STForyoung/SoccerLauncher/files/designSkribble.jpg

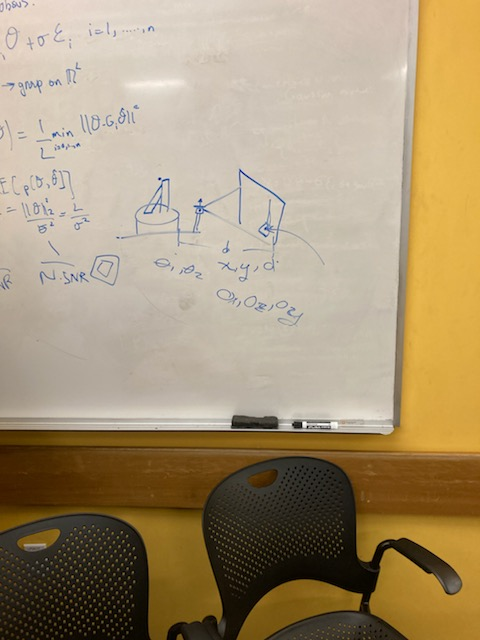
files/designSkribble.jpg
