STForyoung/SoccerLauncher/images/IMG-8528.jpg

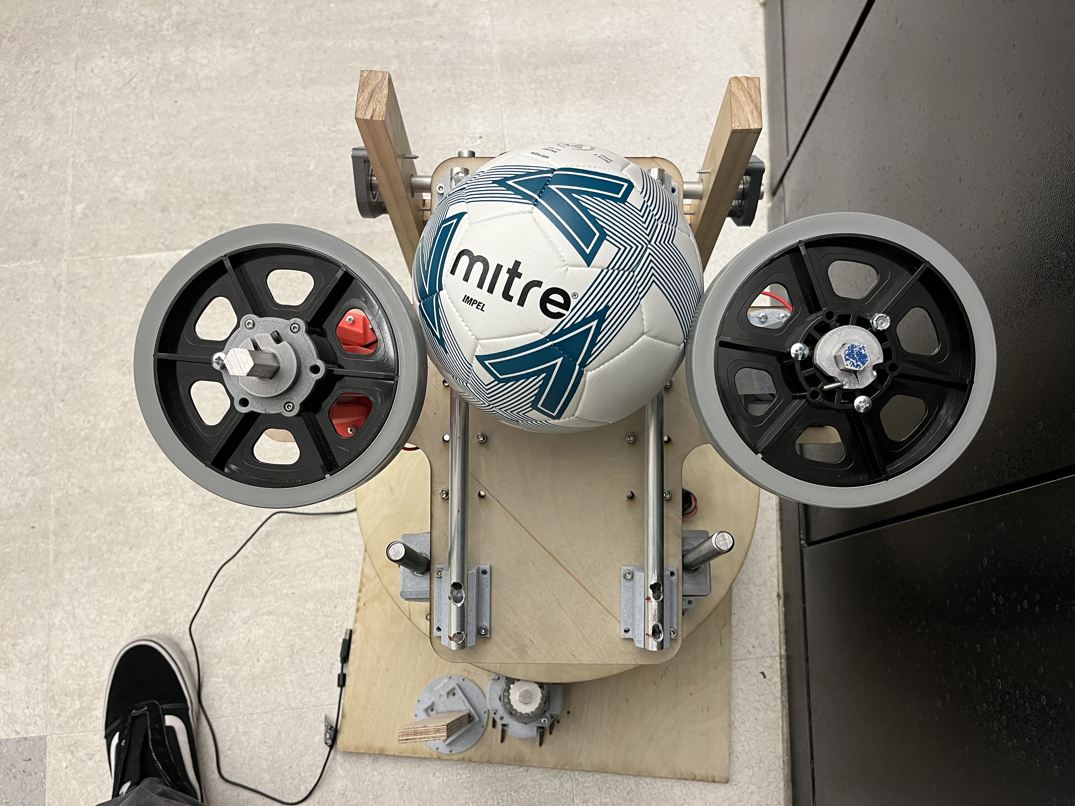
images/IMG-8528.jpg
