STForyoung/SoccerLauncher/images/IMG-8530.jpg

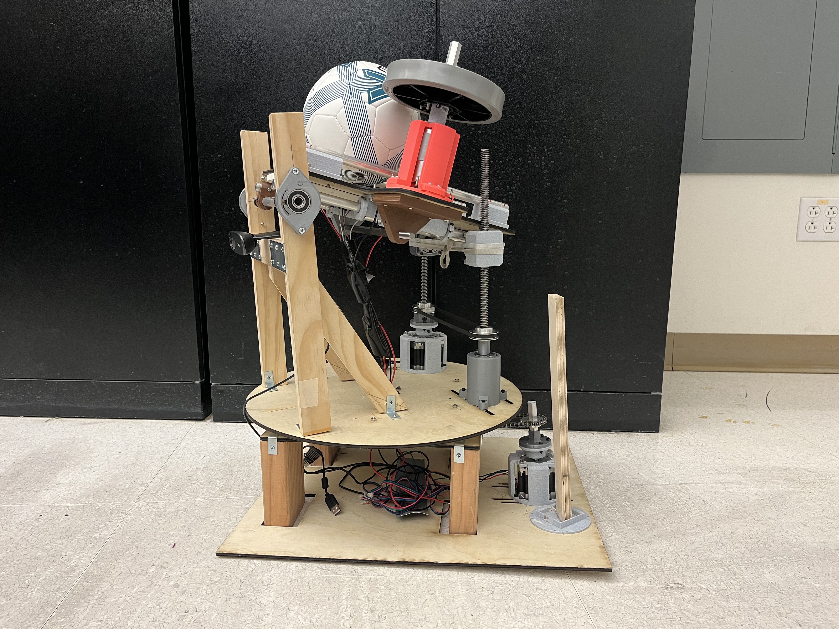
images/IMG-8530.jpg
