STForyoung/SoccerLauncher/images/kaushal.jpg

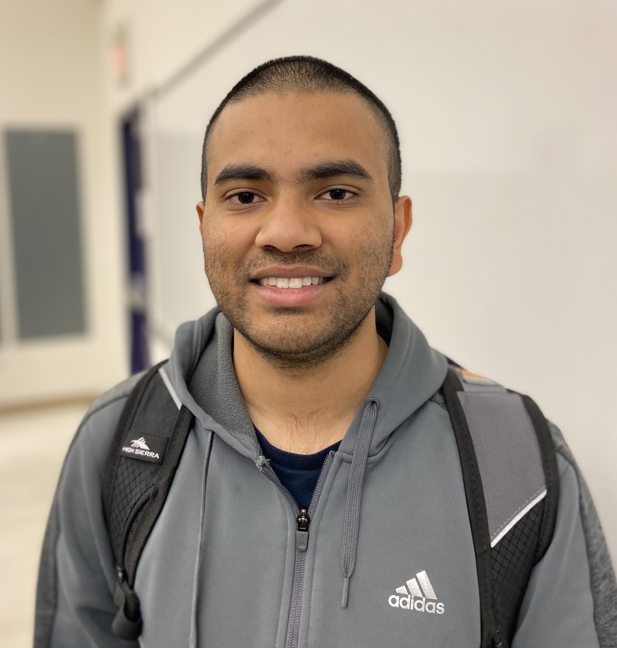
images/kaushal.jpg
