STForyoung/SoccerLauncher/images/neil.jpg

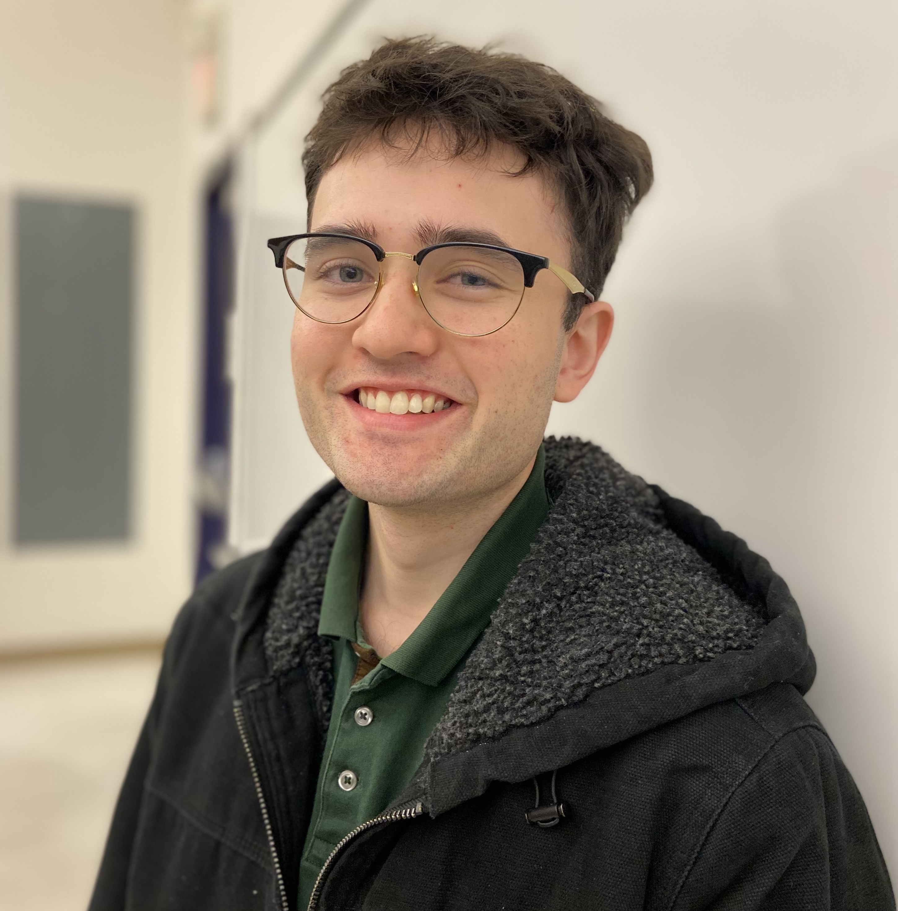
images/neil.jpg
