STForyoung/SoccerLauncher/images/sebastian.jpg

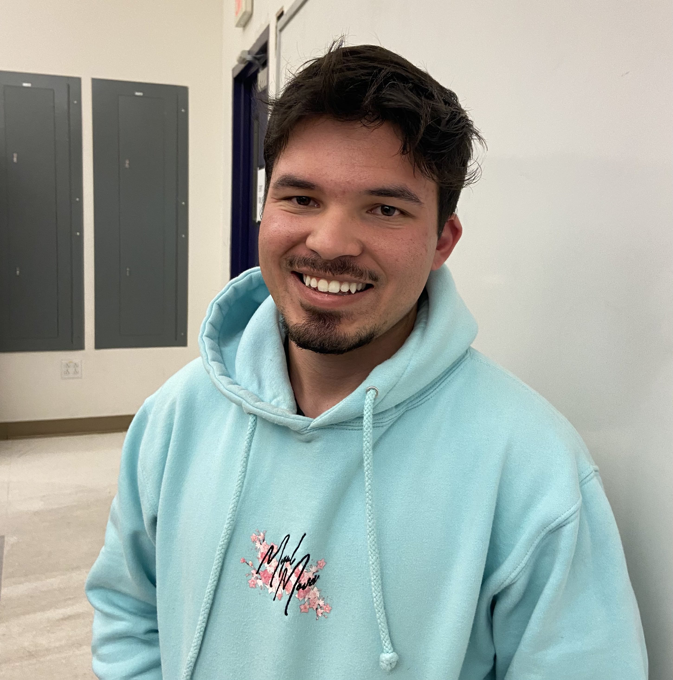
images/sebastian.jpg
