STForyoung/SoccerLauncher/images/steve.jpg

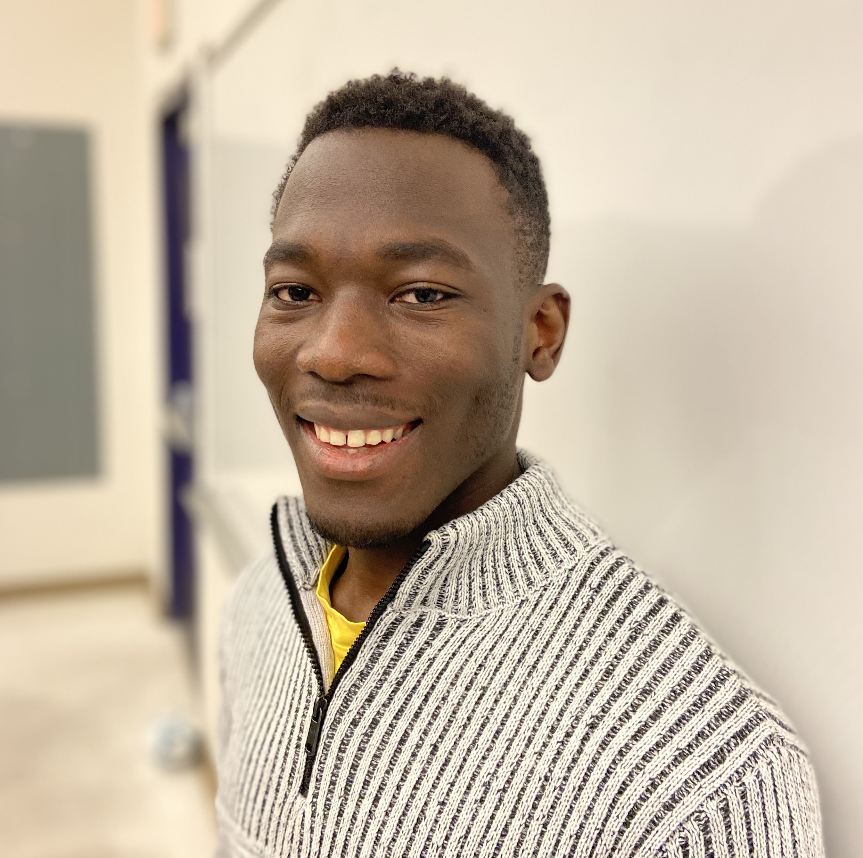
images/steve.jpg
