STForyoung/SoccerLauncher/results.html

### Results

###### Building your own robot is rewarding, but very difficult.

###### Most of our time was spent designing, fabricating, and assembling our robot. We consider its mechanical design to be mostly a success. The basic design is that launch pitch is adjusted by moving one of the attachment points up and down a leadscrew while the yaw is adjusted with chain and sprocket.

iphone-mockup

###### Some of the cool mechical/design features include the turnbuckle that allows us to change the distance between the shooter wheels and adjust compression of the soccer ball.

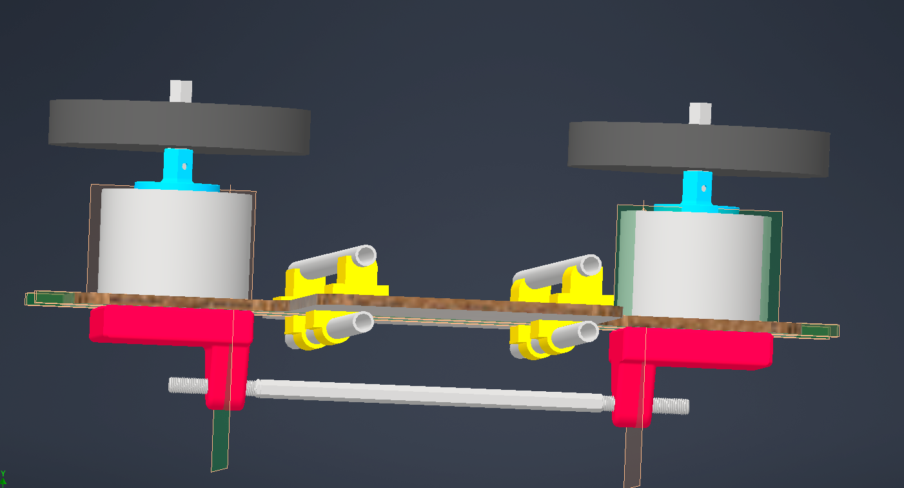
[picture p12: images/turn_buckle.png]


###### There were also 3D printed parts that needed to attach to threaded components. Due to the unreliability of a plastic thread, we decided to insert nuts into the parts during printing.

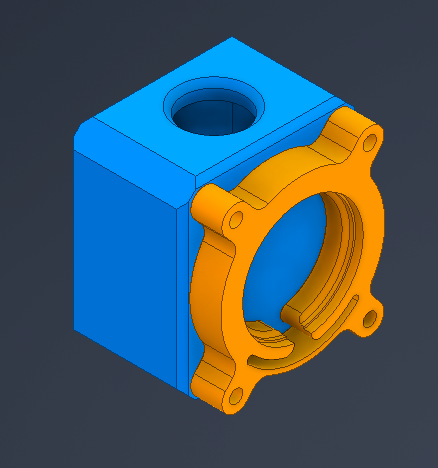
[picture p13: images/bearing_on_screw.PNG]
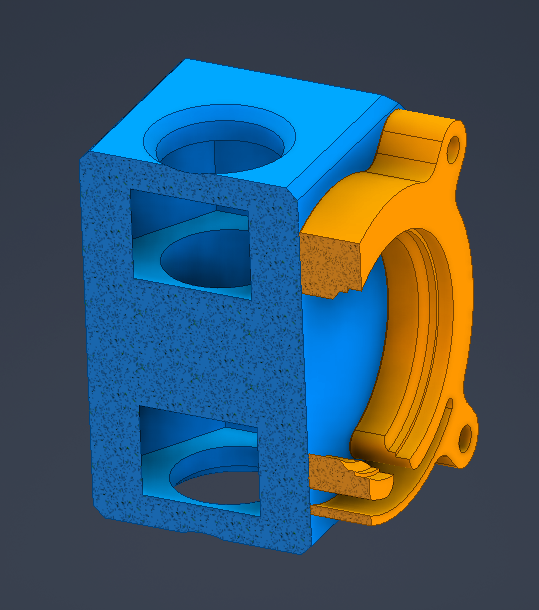
[picture p14: images/half_section.PNG]
 

###### The pulley and chain need the right amount of tension, so we design slots into our laser cut pieces in order to make these adjustable.

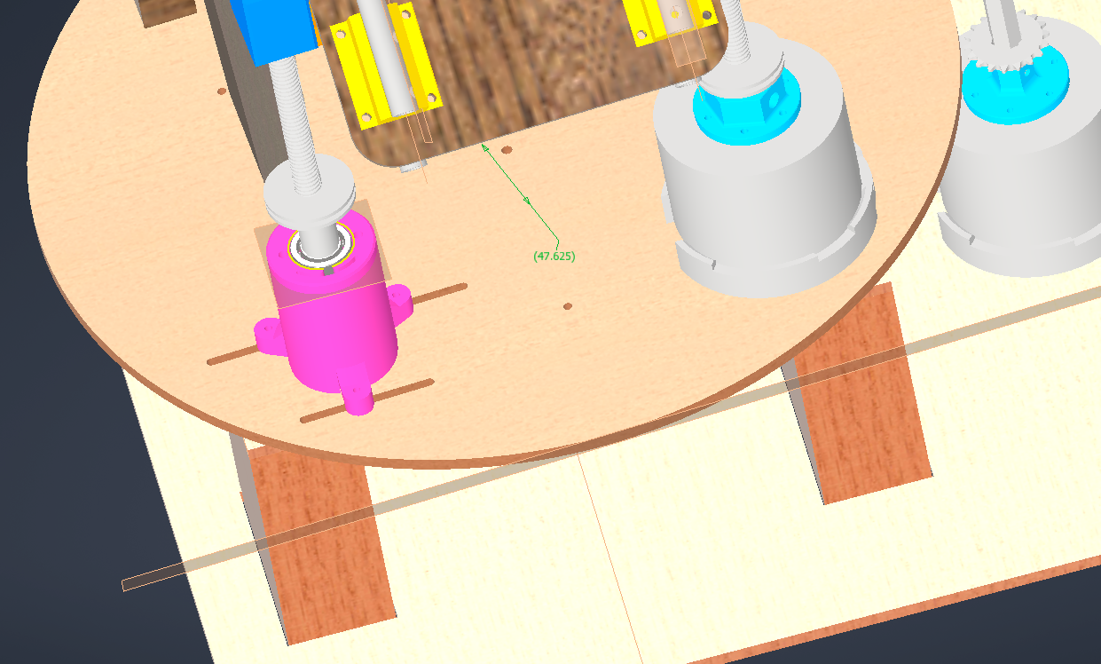
[picture p15: images/slots.PNG]


However, our design still has many issues. In particular, many of these adjustable pieces were very sensitive to vibration and required frequent retightening. More importatly, our project has burnt out many motors. This makes us wonder whether our mechanical design inherently places lots of stress on the actuator.

For the electronics, we were initially using brushless motors with a custom designed controller PCB and gearbox that were kindly provided to us by the Hybrid Robotics Lab. However, we were suddenly unable to communicate with these motors through CAN the day before our presentation. A friend of ours generously loaned us NEMA 17 stepper motors. We were unfamiliar with using stepper motor drivers but eventually managed to control them and attempted to present them, however this particular model was not able to provide enough torque to move the assembly. This can be heard in the sensing demo below.

We spent the last week of the semester integrating NEMA 23's: a stronger model of stepper motors. These were able to move the assembly and we made good progress with the integrating our generate angle python script with the Stepper.h arduino library. However, our CNC shield also seemed to burn out on December 15th. We then resorted to disassembling Sebastian's 3D printer to use the 3D printer controller board to control the stepper motors. This caused issues that were not fixable within our tight timespan, as the 3D printer control board cannot control number of steps the same way that the CNC shield was able to.

We also needed motors for shooting without access to the lab's. For this, we chose brushed motors instead of steppers because we needed speed and not accuracy. These motors came with a different set of encoders and challenges. We were able to develop a mechanical design that would attach them to the assembly, but we simply did not have the time to invest in both the brushed and stepper motors. We prioritized the latter, as the AR tracking better integrates sensing, planning, and actuation.

In the end, we were able to change the pitch and yaw of the motors using the 3D printed board and spin the brushed motors, but our control does not work correctly for either of them. Given more time to complete the project we would buy another arduino cnc shield and develop that way or redesign our planning in order to use the 3D printer board. Hopefully this time we fix our electronics bugs and re-implement the control we had working initially.

### Sensing Demo

### Actuation Demo

### Actuation Demo 2

### AR Tag Demo

### Conclusion

We learned a lot from this project. It was a truly memorable experience. Special thanks:
Yufeng Chi and Zhongyu Li for all the support throughout the project.
Max Braunstein for helping with machining parts
Thanh T. Tran for the original stepper motors setup
Cody and Adam from Jacobs Hall Makerspace for help with fabrication.

© Copyright 2022 SoccerLauncher
