STForyoung/SoccerLauncher/images/IMG-8534.jpg

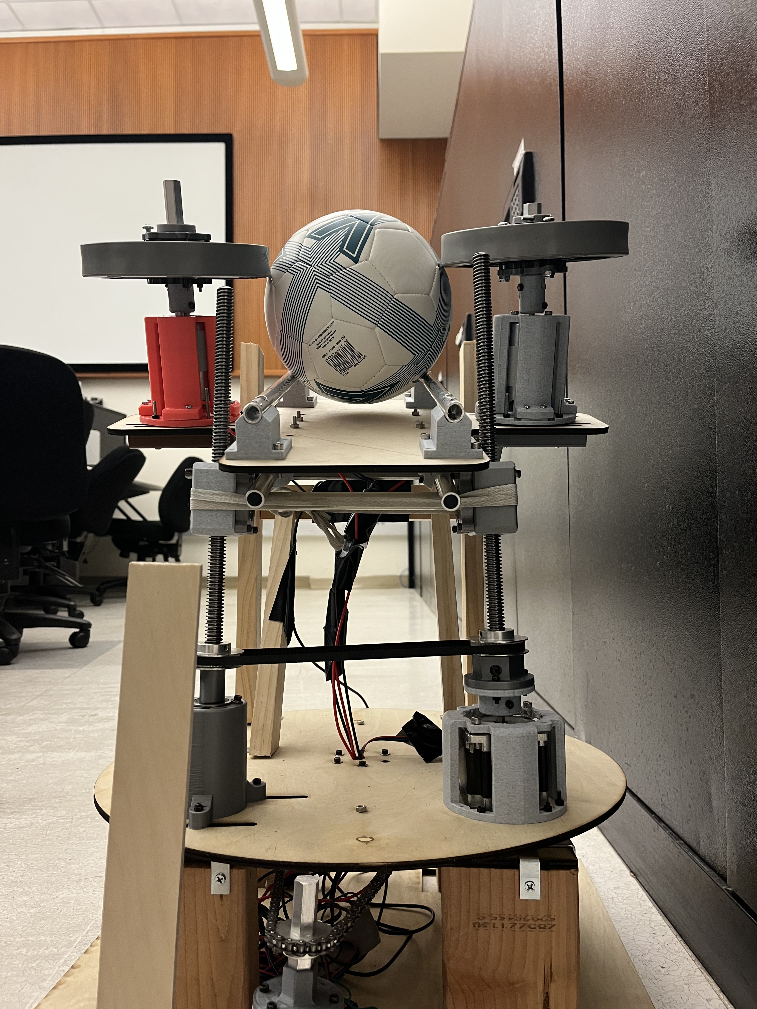
images/IMG-8534.jpg
