STForyoung/SoccerLauncher/images/launcher.jpg

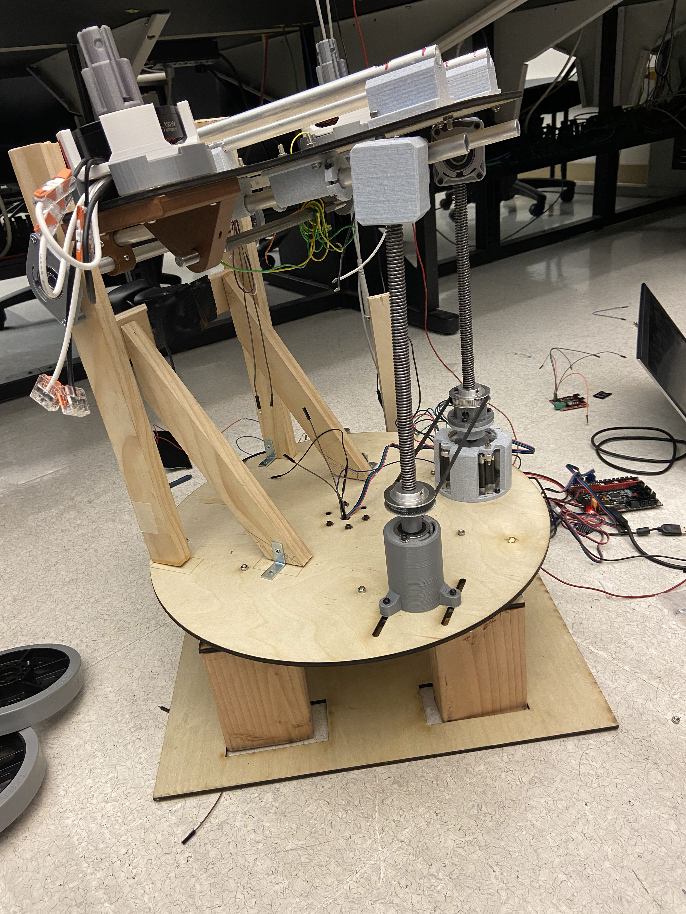
images/launcher.jpg
